Khoi281248/Swarm_Robot_Hardware/docs/placement_driver_rotated.png

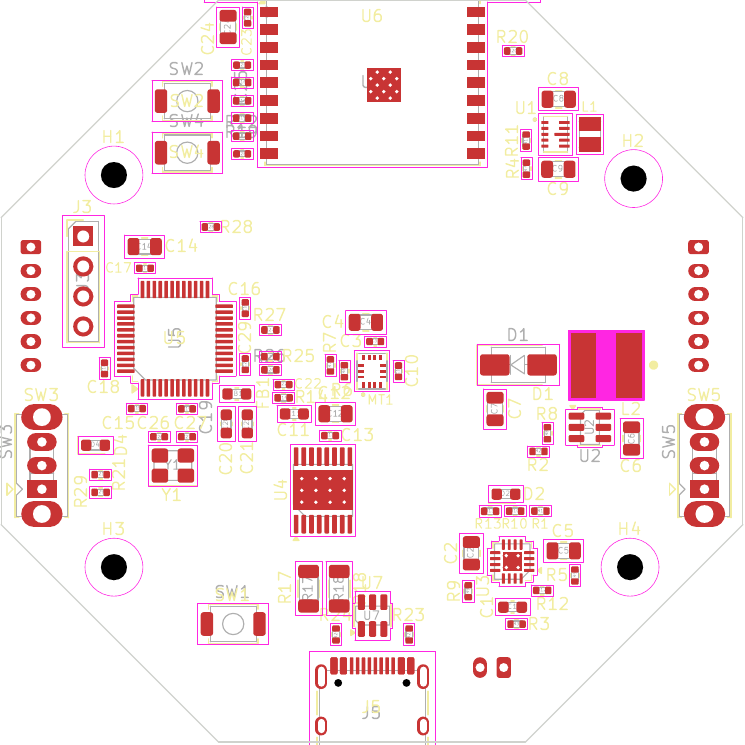
docs/placement_driver_rotated.png
