Khoi281248/Swarm_Robot_Hardware/docs/routed_main_B.png

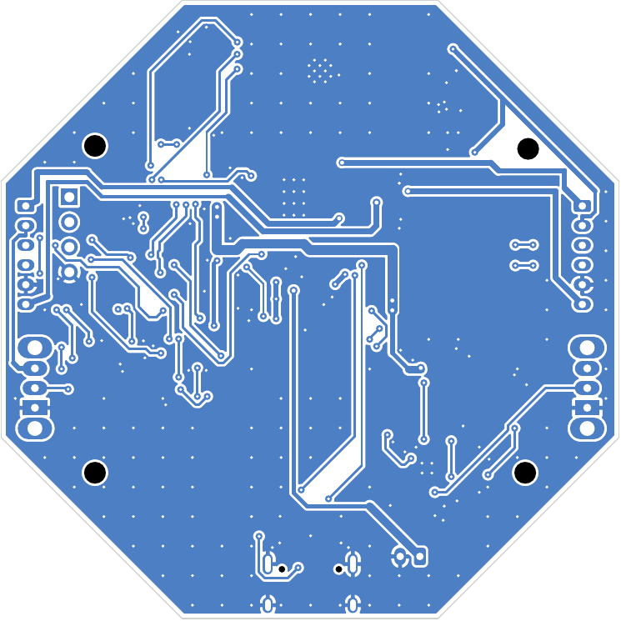
docs/routed_main_B.png
