Khoi281248/Swarm_Robot_Hardware/docs/routed_main_F.png

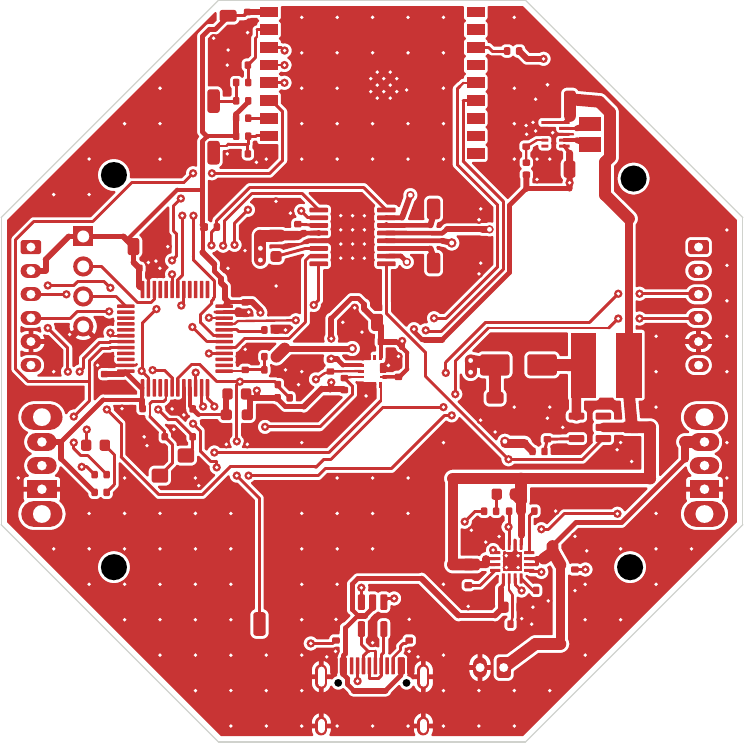
docs/routed_main_F.png
