Khoi281248/Swarm_Robot_Hardware/production/BOM_JLCPCB.csv

Comment | Designator | Footprint | LCSC Part # | Qty
1uF | C1,C20,C21 | Capacitor_SMD:C_0603_1608Metric | C15849 | 3
22uF | C2,C6,C7,C9 | Capacitor_SMD:C_0805_2012Metric | C45783 | 4
100nF | C3,C15,C16,C17,C18,C22,C23,C28,C29 | Capacitor_SMD:C_0402_1005Metric | C1525 | 9
10uF | C4,C5,C8,C12,C14,C24 | Capacitor_SMD:C_0805_2012Metric | C15850 | 6
10nF | C10,C13,C19 | Capacitor_SMD:C_0402_1005Metric | C15195 | 3
2.2uF | C11 | Capacitor_SMD:C_0603_1608Metric | C23630 | 1
1uF | C25 | Capacitor_SMD:C_0402_1005Metric | C52923 | 1
10pF | C26,C27 | Capacitor_SMD:C_0402_1005Metric | C32949 | 2
SS34 | D1 | Diode_SMD:D_SMA | C8678 | 1
LED_RED | D2,D4 | LED_SMD:LED_0603_1608Metric | C2286 | 2
120R | FB1 | Inductor_SMD:L_0603_1608Metric | C14709 | 1
USB_C_Receptacle_USB2.0_16P | J5 | Connector_USB:USB_C_Receptacle_HRO_TYPE-C-31-M-12 | C165948 | 1
0.47uH | L1 | Footprint:INDC2016X120N | C668312 | 1
4.7uH | L2 | Footprint:WE-PD2_5848 | C14258 | 1
ICM-42670-P | MT1 | Footprint:XDCR_ICM-42670-P | C3288646 | 1
100k | R1,R25,R26 | Resistor_SMD:R_0402_1005Metric | C25741 | 3
200k | R2 | Resistor_SMD:R_0402_1005Metric | C25764 | 1
47k | R3 | Resistor_SMD:R_0402_1005Metric | C25792 | 1
56k | R4 | Resistor_SMD:R_0402_1005Metric | C25796 | 1
10k | R5,R10,R11,R14,R15,R19,R20,R21,R22,R27,R28 | Resistor_SMD:R_0402_1005Metric | C25744 | 11
4.7K | R6,R7 | Resistor_SMD:R_0402_1005Metric | C25900 | 2
22k | R8 | Resistor_SMD:R_0402_1005Metric | C25768 | 1
1.2k | R9,R12 | Resistor_SMD:R_0402_1005Metric | C25862 | 2
1k | R13,R29 | Resistor_SMD:R_0402_1005Metric | C11702 | 2
100 | R16 | Resistor_SMD:R_0402_1005Metric | C25076 | 1
0.2 | R17,R18 | Resistor_SMD:R_1206_3216Metric | C160920 | 2
5k1 | R23,R24 | Resistor_SMD:R_0402_1005Metric | C25905 | 2
SW_Push | SW1,SW2,SW4 | Button_Switch_SMD:SW_SPST_TS-1088-xR025 | C720477 | 3
TPS63802DLAR | U1 | Footprint:VREG_TPS63802DLAR | C2845237 | 1
MT3608 | U2 | Package_TO_SOT_SMD:SOT-23-6 | C84817 | 1
BQ24075RGT | U3 | Package_DFN_QFN:VQFN-16-1EP_3x3mm_P0.5mm_EP1.6x1.6mm_ThermalVias | C15464 | 1
DRV8833PWP | U4 | Package_SO:HTSSOP-16-1EP_4.4x5mm_P0.65mm_EP3.4x5mm_Mask2.46x2.31mm_ThermalVias | C50506 | 1
STM32F103C8T6 | U5 | Package_QFP:LQFP-48_7x7mm_P0.5mm | C8734 | 1
ESP32-C3-WROOM-02 | U6 | RF_Module:ESP32-C3-WROOM-02 | C2934560 | 1
USBLC6-2SC6 | U7 | Package_TO_SOT_SMD:SOT-23-6 | C7519 | 1
16MHz | Y1 | Crystal:Crystal_SMD_3225-4Pin_3.2x2.5mm | C13738 | 1
