Khoi281248/Swarm_Robot_Hardware/Swarm_robot_project.pdf

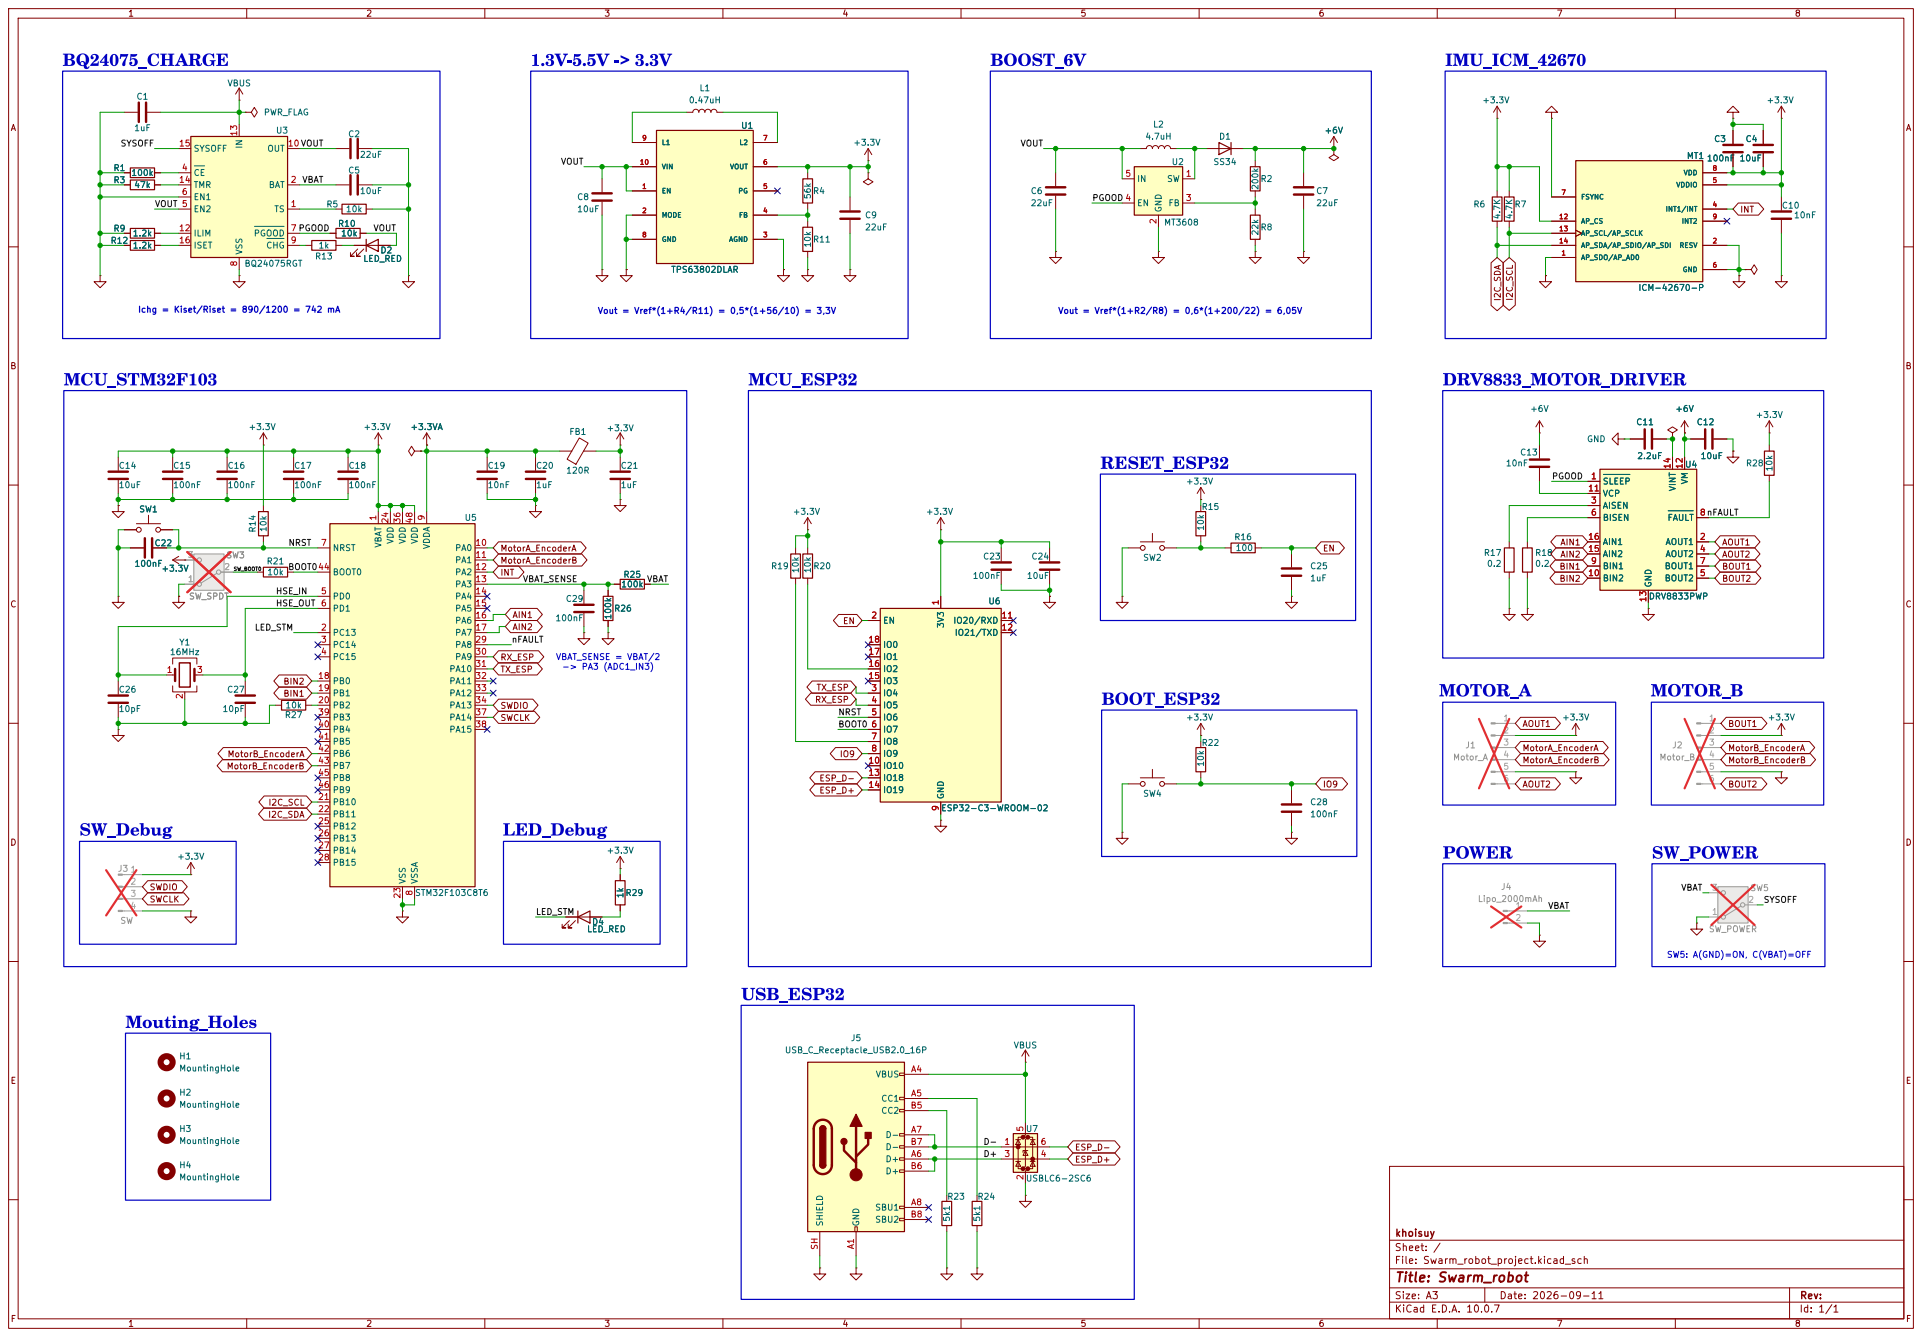
[picture p9: page 1]

Ichg = Kiset/Riset = 890/1200 = 742 mA MCU_STM32F103

SW5: A(GND)=ON, C(VBAT)=OFF

Size: A3 | Rev: | F Date: 2026-09-11
KiCad E.D.A. 10.0.7 | Id: 1/1
