Khoi281248/Swarm_Robot_Hardware/Swarm_robot_project.kicad_pcb

## KiCad design Swarm_robot_project.kicad_pcb (2026-10-27)

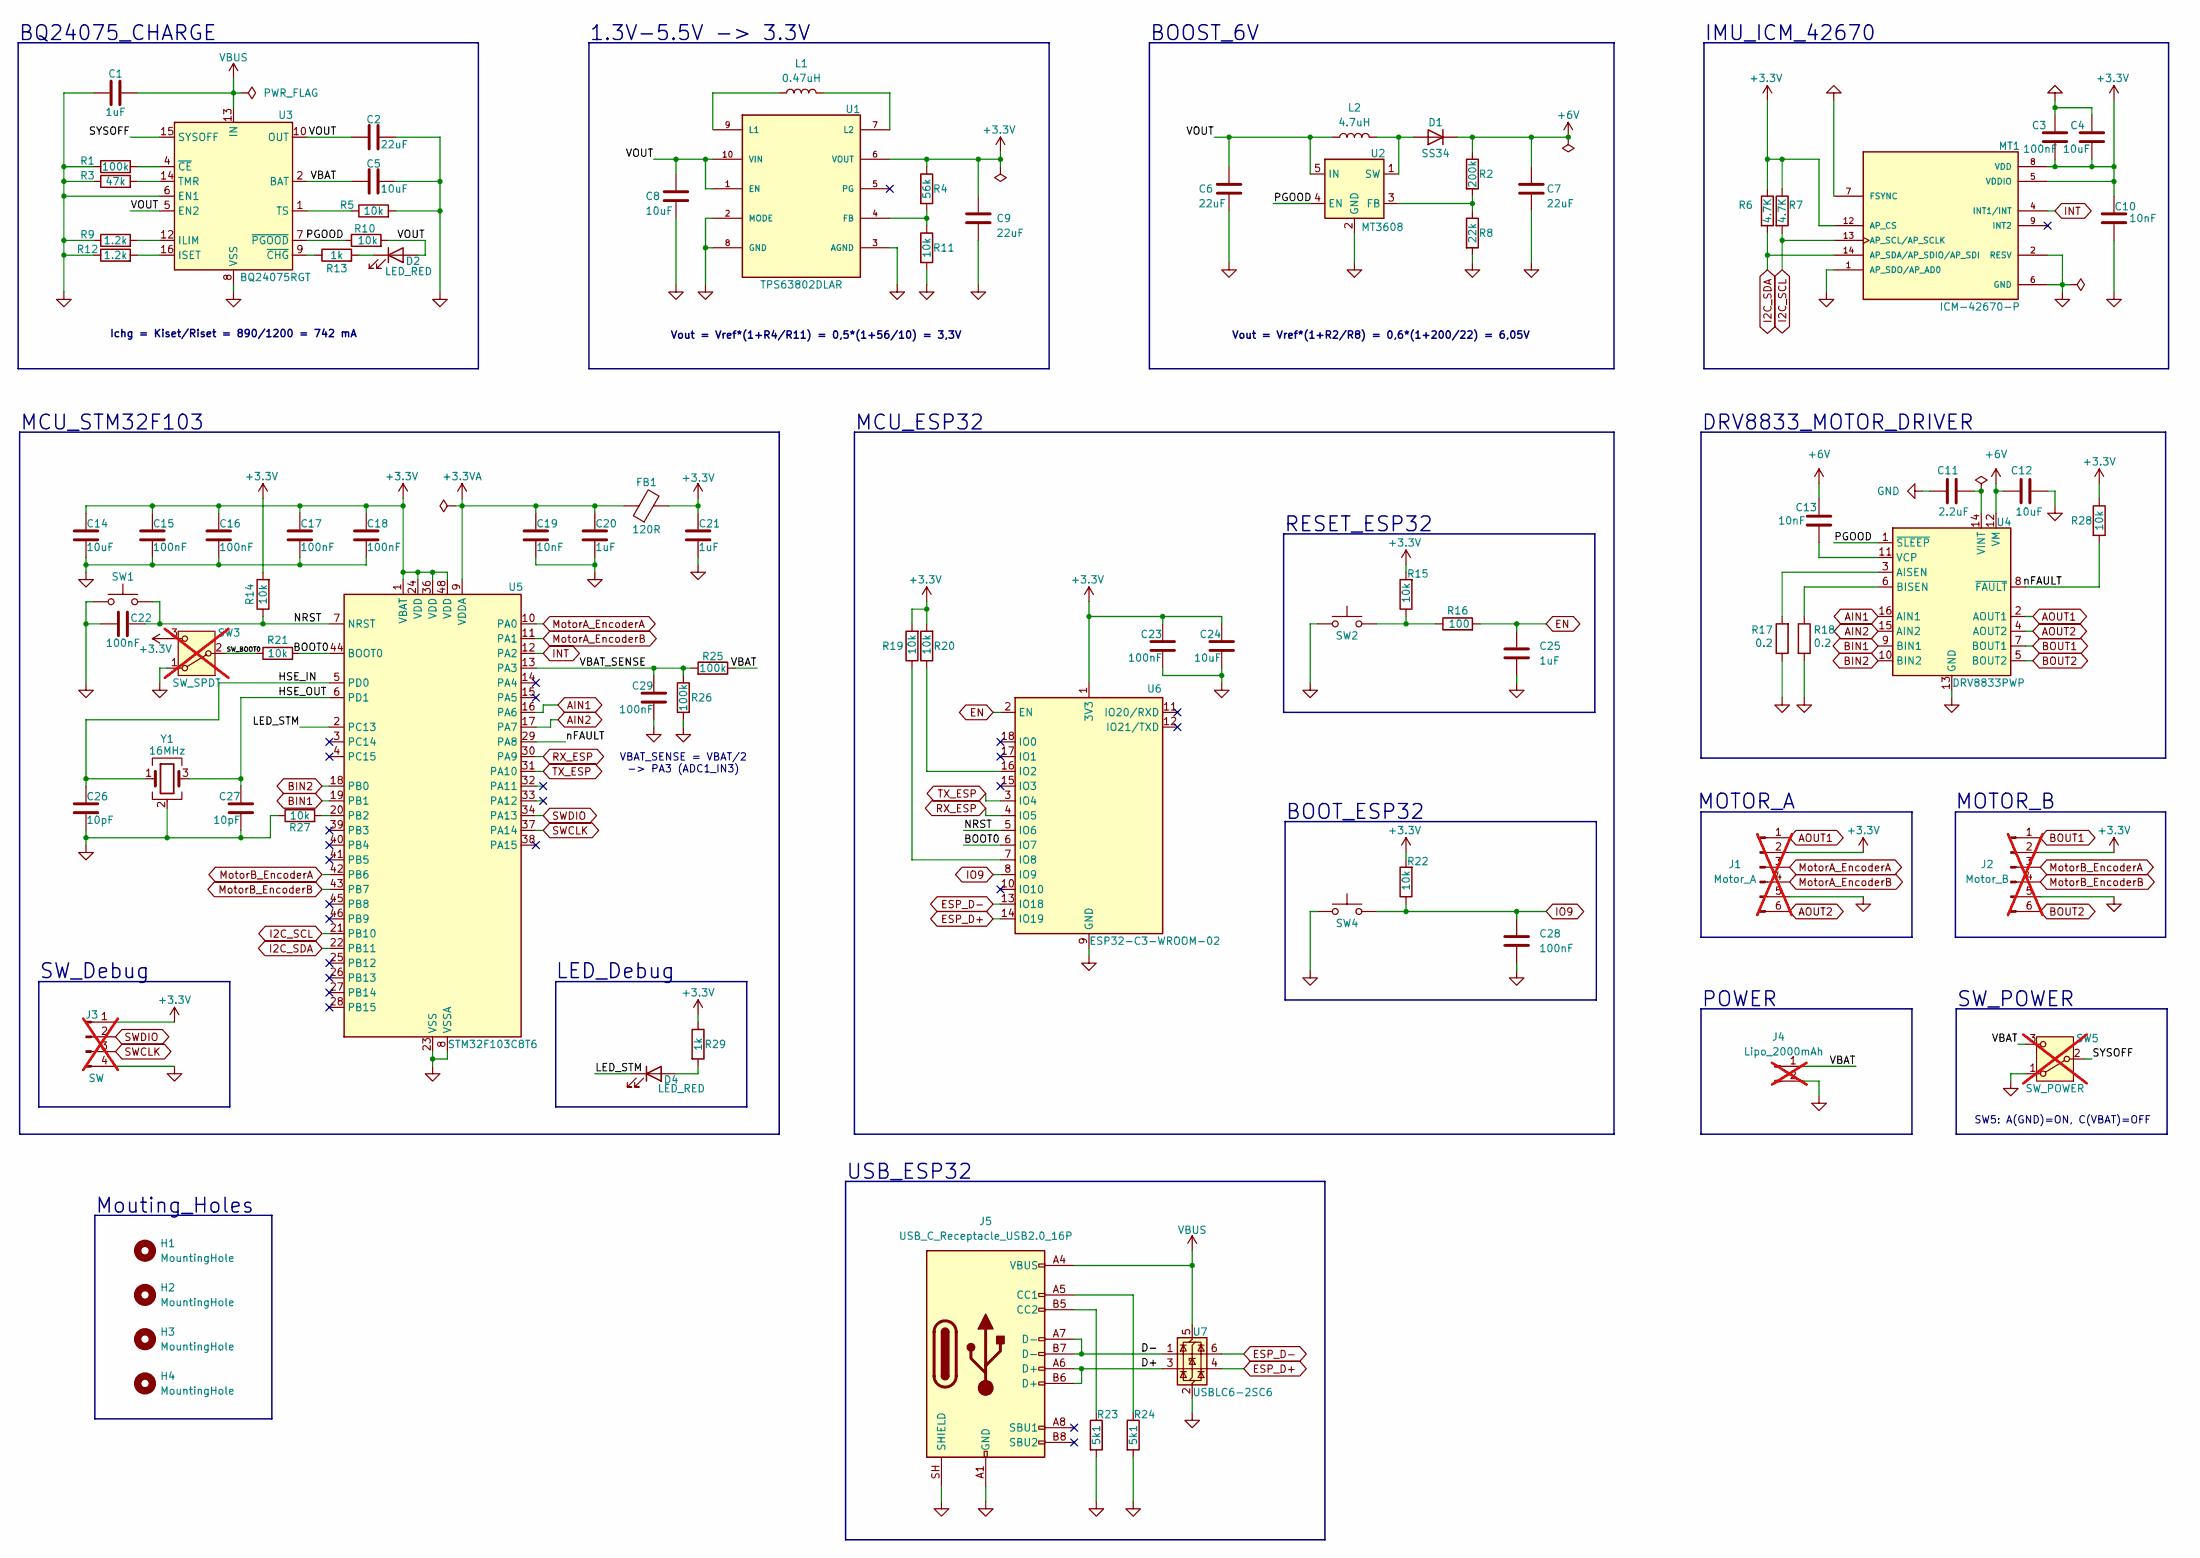
[picture p10: schematic Swarm_robot_project.kicad_sch, Swarm_robot]

Parts:
C1, C20, C21: 1uF; C_0603_1608Metric; LCSC C15849
C2, C6, C7, C9: 22uF; C_0805_2012Metric; LCSC C45783
C3, C15, C16, C17, C18, C22, C23, C28, C29: 100nF; C_0402_1005Metric; LCSC C1525
C4, C5, C8, C12, C14, C24: 10uF; C_0805_2012Metric; LCSC C15850
C10, C13, C19: 10nF; C_0402_1005Metric; LCSC C15195
C11: 2.2uF; C_0603_1608Metric; LCSC C23630
C25: 1uF; C_0402_1005Metric; LCSC C52923
C26, C27: 10pF; C_0402_1005Metric; LCSC C32949
D1: SS34; D_SMA; LCSC C8678
D2, D4: LED_RED; LED_0603_1608Metric; LCSC C2286
FB1: 120R; L_0603_1608Metric; LCSC C14709
H1, H2, H3, H4: MountingHole; MountingHole_2.2mm_M2
J1: Motor_A; JST_PH_B6B-PH-K_1x06_P2.00mm_Vertical; LCSC C131342; not fitted
J2: Motor_B; JST_PH_B6B-PH-K_1x06_P2.00mm_Vertical; LCSC C131342; not fitted
J3: SW; PinHeader_1x04_P2.54mm_Vertical; LCSC C53055674; not fitted
J4: Lipo_2000mAh; JST_PH_B2B-PH-K_1x02_P2.00mm_Vertical; LCSC C2908623; not fitted
J5: USB_C_Receptacle_USB2.0_16P; USB_C_Receptacle_HRO_TYPE-C-31-M-12; LCSC C165948
L1: 0.47uH; INDC2016X120N; LCSC C668312
L2: 4.7uH; WE-PD2_5848; LCSC C14258
MT1: ICM-42670-P; XDCR_ICM-42670-P; PARTREV 1.1; LCSC C3288646
R1, R25, R26: 100k; R_0402_1005Metric; LCSC C25741
R2: 200k; R_0402_1005Metric; LCSC C25764
R3: 47k; R_0402_1005Metric; LCSC C25792
R4: 56k; R_0402_1005Metric; LCSC C25796
R5, R10, R11, R14, R15, R19, R20, R21, R22, R27, R28: 10k; R_0402_1005Metric; LCSC C25744
R6, R7: 4.7K; R_0402_1005Metric; LCSC C25900
R8: 22k; R_0402_1005Metric; LCSC C25768
R9, R12: 1.2k; R_0402_1005Metric; LCSC C25862
R13, R29: 1k; R_0402_1005Metric; LCSC C11702
R16: 100; R_0402_1005Metric; LCSC C25076
R17, R18: 0.2; R_1206_3216Metric; LCSC C160920
R23, R24: 5k1; R_0402_1005Metric; LCSC C25905
SW1, SW2, SW4: SW_Push; SW_SPST_TS-1088-xR025; LCSC C720477
SW3: SW_SPDT; SW_Slide_SPDT_Straight_CK_OS102011MS2Q; LCSC C221829; not fitted
SW5: SW_POWER; SW_Slide_SPDT_Straight_CK_OS102011MS2Q; LCSC C221829; not fitted
U1: TPS63802DLAR; VREG_TPS63802DLAR; PARTREV B; LCSC C2845237
U2: MT3608; SOT-23-6; LCSC C84817
U3: BQ24075RGT; VQFN-16-1EP_3x3mm_P0.5mm_EP1.6x1.6mm_ThermalVias; LCSC C15464
U4: DRV8833PWP; HTSSOP-16-1EP_4.4x5mm_P0.65mm_EP3.4x5mm_Mask2.46x2.31mm_The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; LCSC C50506
U5: STM32F103C8T6; LQFP-48_7x7mm_P0.5mm; LCSC C8734
U6: ESP32-C3-WROOM-02; LCSC C2934560
U7: USBLC6-2SC6; SOT-23-6; LCSC C7519
Y1: 16MHz; Crystal_SMD_3225-4Pin_3.2x2.5mm; LCSC C13738

Connections:
+3.3V: C3.2, C4.2, C9.1, C10.1, C14.1, C15.1, C16.1, C17.1, C18.1, C21.1, C23.1, C24.1, FB1.2, J1.2, J2.2, J3.1, MT1.5 (VDDIO), MT1.8 (VDD), MT1.12 (AP_CS), R4.1, R6.1, R7.1, R14.2, R15.2, R19.2, R20.2, R22.2, R28.1, R29.1, SW3.3 (C), U1.6 (VOUT), U5.1 (VBAT), U5.24 (VDD), U5.36 (VDD), U5.48 (VDD), U6.1 (3V3)
+3.3VA: C19.1, C20.1, FB1.1, U5.9 (VDDA)
+6V: C7.1, C12.1, C13.2, D1.1 (K), R2.1, U4.12 (VM)
/BOOT0: R21.2, U5.44 (BOOT0), U6.6 (IO7)
/D+: J5.A6 (D+), J5.B6 (D+), U7.3 (I/O2)
/D-: J5.A7 (D-), J5.B7 (D-), U7.1 (I/O1)
/HSE_IN: C26.1, U5.5 (PD0), Y1.1
/HSE_OUT: C27.1, U5.6 (PD1), Y1.3
/LED_STM: D4.1 (K), U5.2 (PC13)
/NRST: C22.2, R14.1, SW1.2, U5.7 (NRST), U6.5 (IO6)
/PGOOD: R10.1, U2.4 (EN), U3.7 (~PGOOD), U4.1 (~SLEEP)
/SW_BOOT0: R21.1, SW3.2 (B)
/SYSOFF: SW5.2 (B), U3.15 (SYSOFF)
/VBAT: C5.1, J4.1, R25.1, SW5.3 (C), U3.2 (BAT), U3.3 (BAT)
/VBAT_SENSE: C29.1, R25.2, R26.1, U5.13 (PA3)
/VOUT: C2.1, C6.1, C8.1, D2.2 (A), L2.1, R10.2, U1.1 (EN), U1.10 (VIN), U2.5 (IN), U3.5 (EN2), U3.10 (OUT), U3.11 (OUT)
/nFAULT: R28.2, U4.8 (~FAULT), U5.29 (PA8)
AIN1: U4.16 (AIN1), U5.16 (PA6)
AIN2: U4.15 (AIN2), U5.17 (PA7)
AOUT1: J1.1, U4.2 (AOUT1)
AOUT2: J1.6, U4.4 (AOUT2)
BIN1: U4.9 (BIN1), U5.19 (PB1)
BIN2: U4.10 (BIN2), U5.18 (PB0)
BOUT1: J2.1, U4.7 (BOUT1)
BOUT2: J2.6, U4.5 (BOUT2)
EN: C25.1, R16.2, U6.2 (EN)
ESP_D+: U6.14 (IO19), U7.4 (I/O2)
ESP_D-: U6.13 (IO18), U7.6 (I/O1)
GND: C1.1, C2.2, C3.1, C4.1, C5.2, C6.2, C7.2, C8.2, C9.2, C10.2, C11.1, C12.2, C14.2, C15.2, C16.2, C17.2, C18.2, C19.2, C20.2, C21.2, C22.1, C23.2, C24.2, C25.2, C26.2, C27.2, C28.2, C29.2, J1.5, J2.5, J3.4, J4.2, J5.A1 (GND), J5.A12 (GND), J5.B1 (GND), J5.B12 (GND), J5.SH (SHIELD), MT1.1 (AP_SDO/AP_AD0), MT1.2 (RESV), MT1.3 (RESV), MT1.6 (GND), MT1.7 (FSYNC), MT1.10 (RESV), MT1.11 (RESV), R1.1, R3.1, R5.2, R8.2, R9.1, R11.2, R12.1, R17.1, R18.2, R23.2, R24.2, R26.2, R27.1, SW1.1, SW2.1, SW3.1 (A), SW4.1, SW5.1 (A), U1.2 (MODE), U1.3 (AGND), U1.8 (GND), U2.2 (GND), U3.6 (EN1), U3.8 (VSS), U3.17 (VSS), U4.13 (GND), U4.17 (GND), U5.8 (VSSA), U5.23 (VSS), U5.35 (VSS), U5.47 (VSS), U6.9 (GND), U6.19 (GND), U7.2 (GND), Y1.2 (G), Y1.4 (G)
I2C_SCL: MT1.13 (AP_SCL/AP_SCLK), R7.2, U5.21 (PB10)
I2C_SDA: MT1.14 (AP_SDA/AP_SDIO/AP_SDI), R6.2, U5.22 (PB11)
INT: MT1.4 (INT1/INT), U5.12 (PA2)
IO9: C28.1, R22.1, SW4.2, U6.8 (IO9)
MotorA_EncoderA: J1.3, U5.10 (PA0)
MotorA_EncoderB: J1.4, U5.11 (PA1)
MotorB_EncoderA: J2.3, U5.42 (PB6)
MotorB_EncoderB: J2.4, U5.43 (PB7)
unnamed: D1.2 (A), L2.2, U2.1 (SW)
unnamed: D2.1 (K), R13.2
unnamed: D4.2 (A), R29.2
unnamed: J5.A5 (CC1), R24.1
unnamed: J5.B5 (CC2), R23.1
unnamed: R15.1, R16.1, SW2.2
unnamed: R4.2, R11.1, U1.4 (FB)
unnamed: L1.1, U1.9 (L1)
unnamed: L1.2, U1.7 (L2)
unnamed: R2.2, R8.1, U2.3 (FB)
unnamed: R9.2, U3.12 (ILIM)
unnamed: R12.2, U3.16 (ISET)
unnamed: R3.2, U3.14 (TMR)
unnamed: R5.1, U3.1 (TS)
unnamed: R1.2, U3.4 (~CE)
unnamed: R13.1, U3.9 (~CHG)
unnamed: R17.2, U4.3 (AISEN)
unnamed: R18.1, U4.6 (BISEN)
unnamed: C13.1, U4.11 (VCP)
unnamed: C11.2, U4.14 (VINT)
unnamed: R27.2, U5.20 (PB2)
unnamed: R20.1, U6.16 (IO2)
unnamed: R19.1, U6.7 (IO8)
RX_ESP: U5.30 (PA9), U6.4 (IO5)
SWCLK: J3.3, U5.37 (PA14)
SWDIO: J3.2, U5.34 (PA13)
TX_ESP: U5.31 (PA10), U6.3 (IO4)
VBUS: C1.2, J5.A4 (VBUS), J5.A9 (VBUS), J5.B4 (VBUS), J5.B9 (VBUS), U3.13 (IN), U7.5 (VBUS)

Notes on the sheet:
BQ24075_CHARGE
DRV8833_MOTOR_DRIVER
MCU_ESP32
RESET_ESP32
Mouting_Holes
MOTOR_B
IMU_ICM_42670
SW_Debug
BOOST_6V
POWER
VBAT_SENSE = VBAT/2 -> PA3 (ADC1_IN3)
LED_Debug
Vout = Vref*(1+R4/R11) = 0,5*(1+56/10) = 3,3V
USB_ESP32
BOOT_ESP32
1.3V-5.5V -> 3.3V
MOTOR_A
SW_POWER
Vout = Vref*(1+R2/R8) = 0,6*(1+200/22) = 6,05V
Ichg = Kiset/Riset = 890/1200 = 742 mA
MCU_STM32F103
SW5: A(GND)=ON, C(VBAT)=OFF

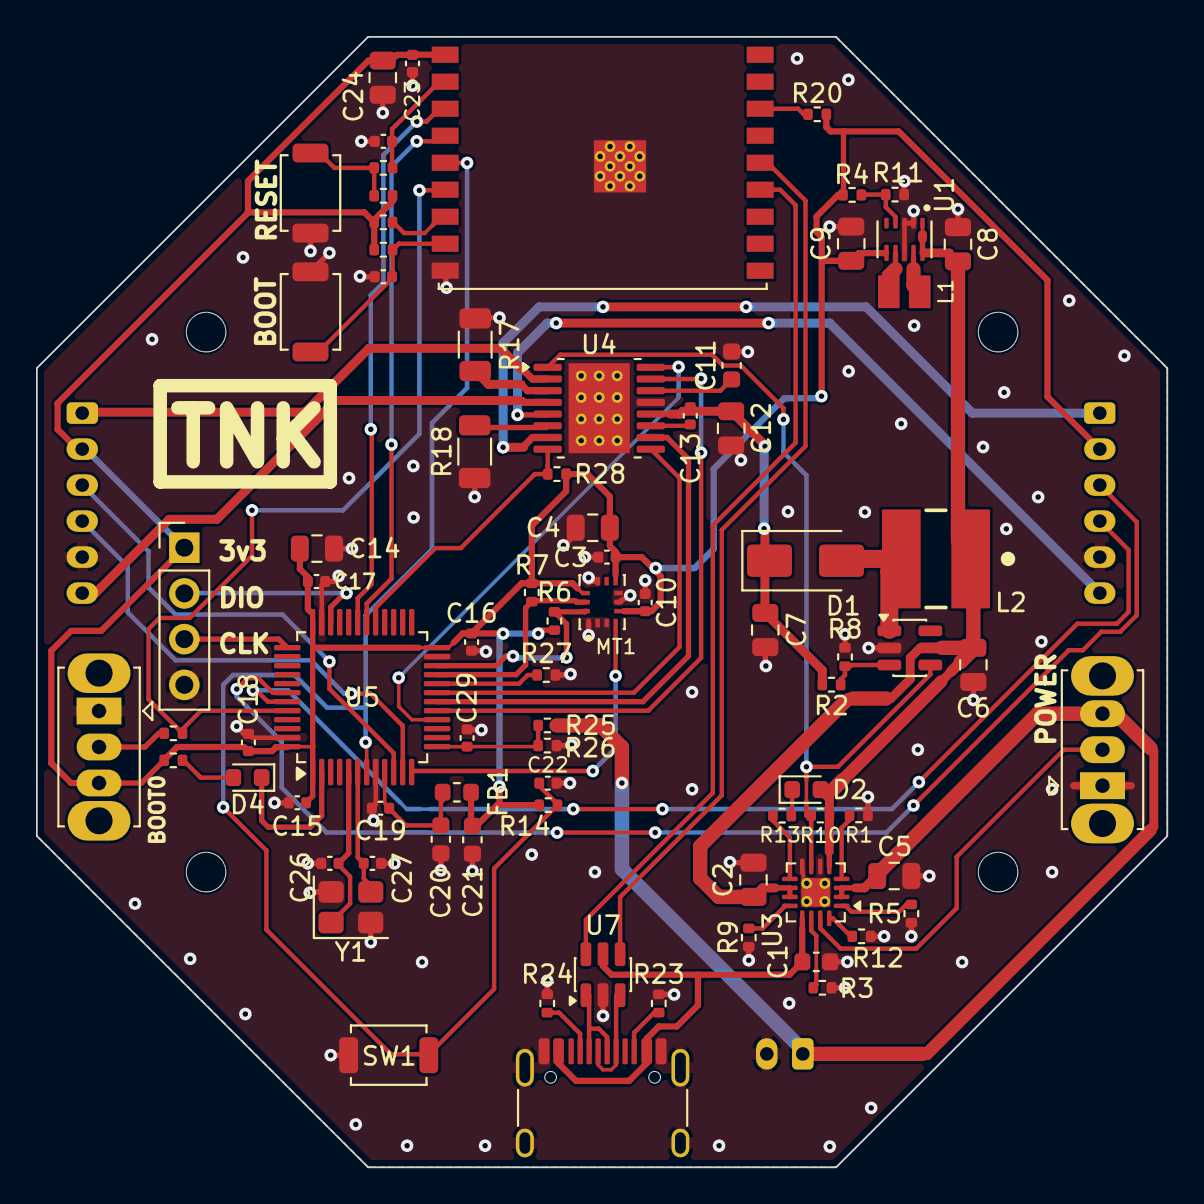
[picture p11: board Swarm_robot_project.kicad_pcb from above]

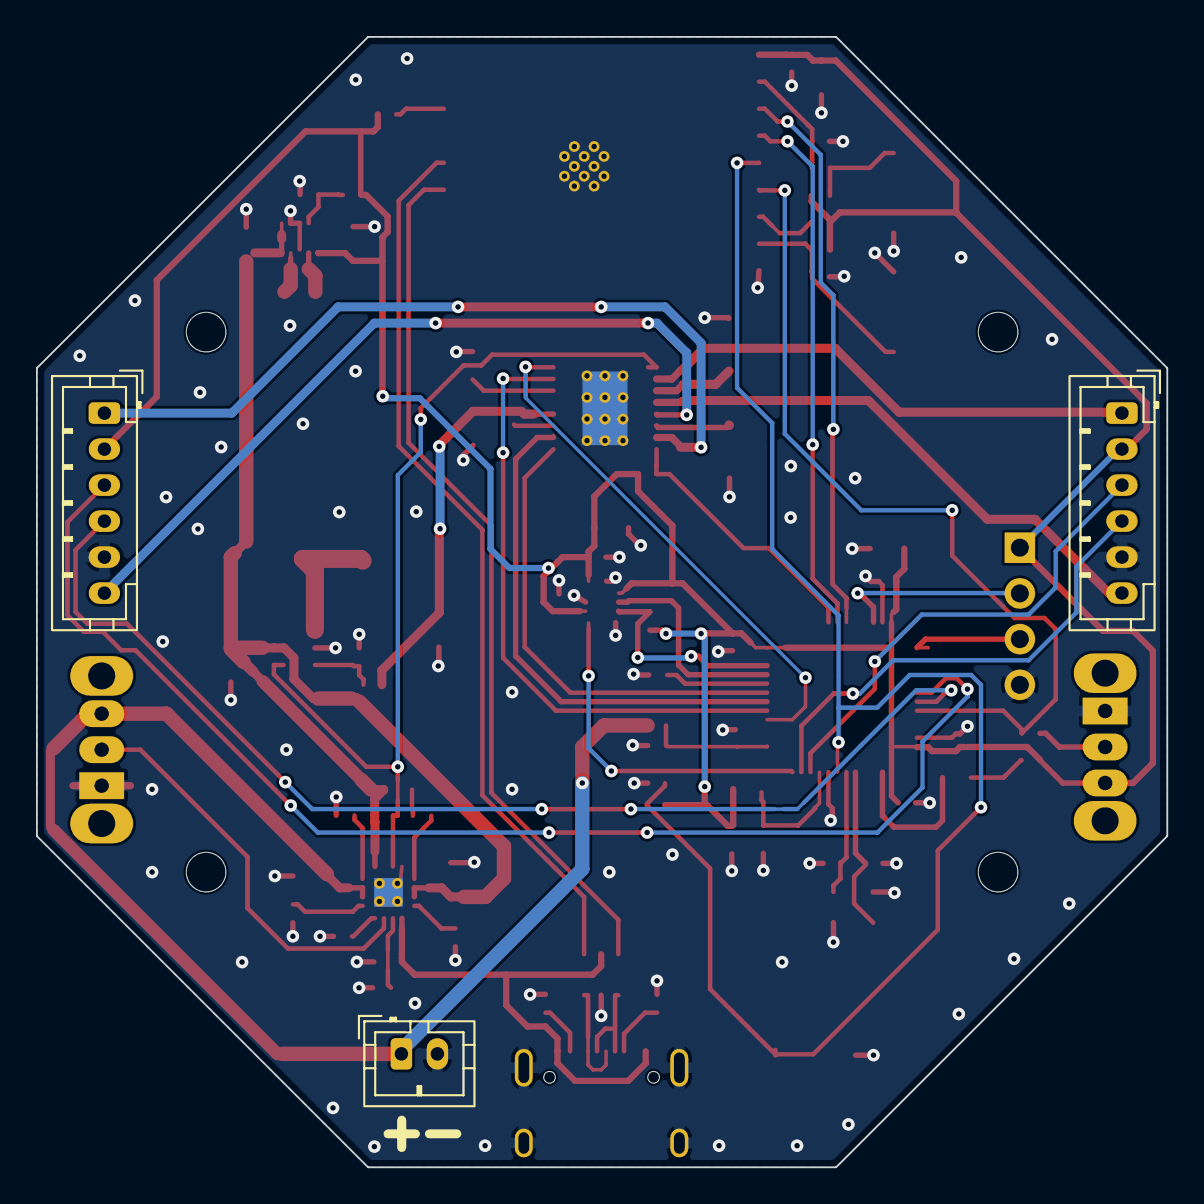
[picture p12: board Swarm_robot_project.kicad_pcb from below]

Board: 2 copper layers, 62.8 x 62.8 mm, 87 parts (3 on the bottom side), 65 nets.
